Eric-Hambley/Capstone-Project/README.md

"# Capstone-Project" 
"# Capstone-Project"
