Eric-Hambley/Capstone-Project/Receiver/Rx Flowchart.pdf

# Receiver

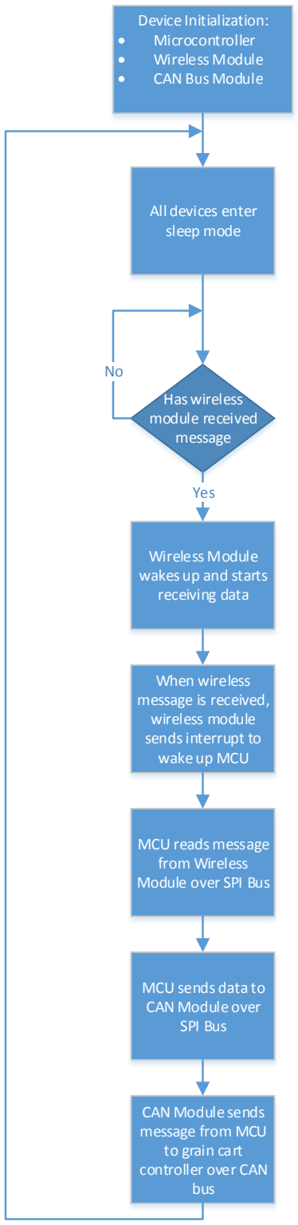
[picture p1: figure]
Device Initialization: • Microcontroller • Wireless Module • CAN Bus Module; All devices enter sleep mode; Has wireless module received message; Wireless Module wakes up and starts receiving data; When wireless message is received, wireless module sends interrupt to wake up MCU; MCU reads message from Wireless Module over SPI Bus; MCU sends data to CAN Module over SPI Bus; CAN Module sends message from MCU to grain cart controller over CAN bus; Yes
