Eric-Hambley/Capstone-Project/Transmitter/Tx Flowchart.pdf

# Transmitter

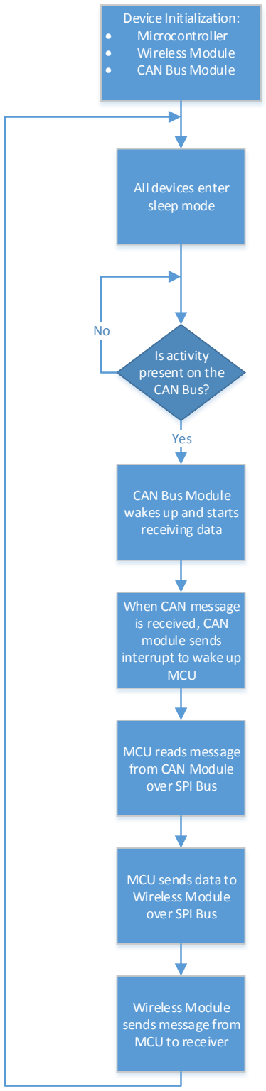
[picture p2: figure]
Device Initialization: • Microcontroller • Wireless Module • CAN Bus Module; All devices enter sleep mode; Is activity present on the CAN Bus?; CAN Bus Module wakes up and starts receiving data; When CAN message is received, CAN module sends interrupt to wake up MCU; MCU reads message from CAN Module over SPI Bus; MCU sends data to Wireless Module over SPI Bus; Wireless Module sends message from MCU to receiver; Yes
