Eric-Hambley/Capstone-Project/Receiver/Receiver Flowchart.pdf

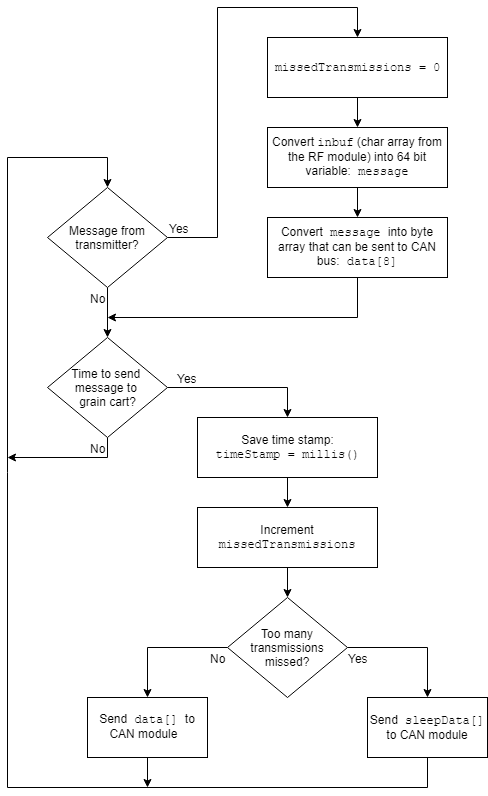
[picture p3: figure]
