Eric-Hambley/Capstone-Project/Transmitter/Transmitter_Battery state machine_flowchart.pdf

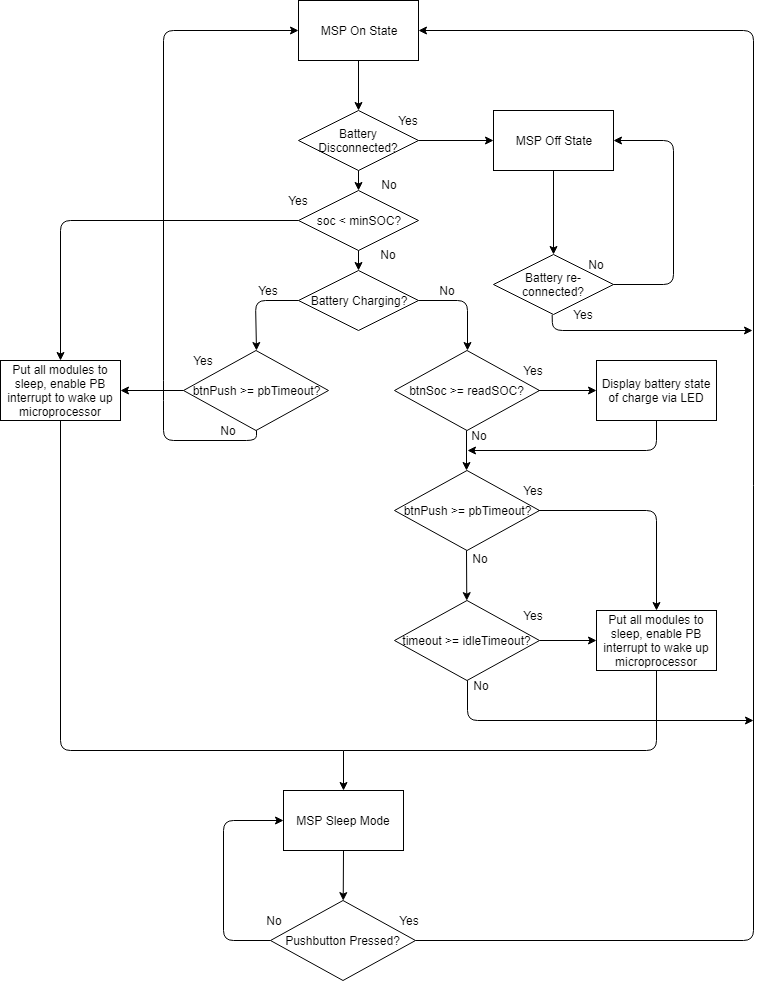
[picture p4: figure]
