Eric-Hambley/Capstone-Project/High Level Wiring Diagram.png

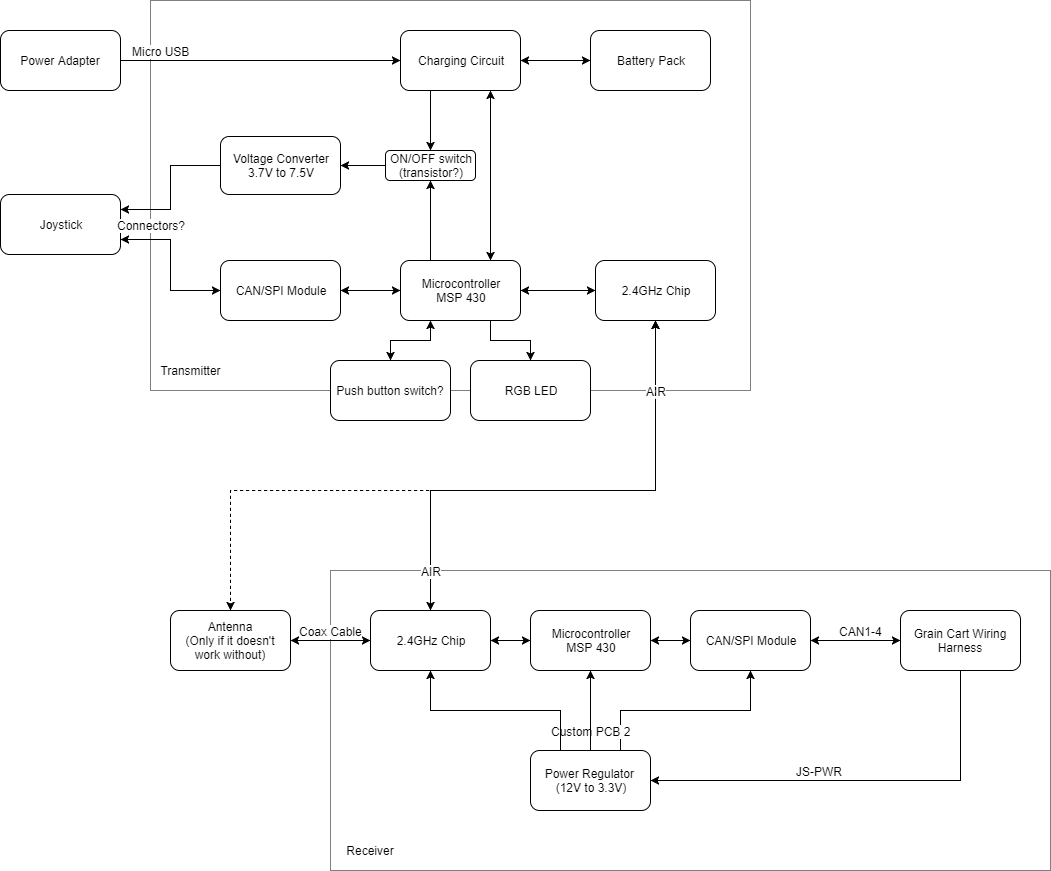
High Level Wiring Diagram.png
